fabricadigital/EzTemp-for-Raspberry-Pi/README.md

EzTempRH-for-Raspberry-Pi
=========================
