fabricadigital/EzTemp-for-Raspberry-Pi/board/EzTempRH-for-Raspberry-Pi Schematic.pdf

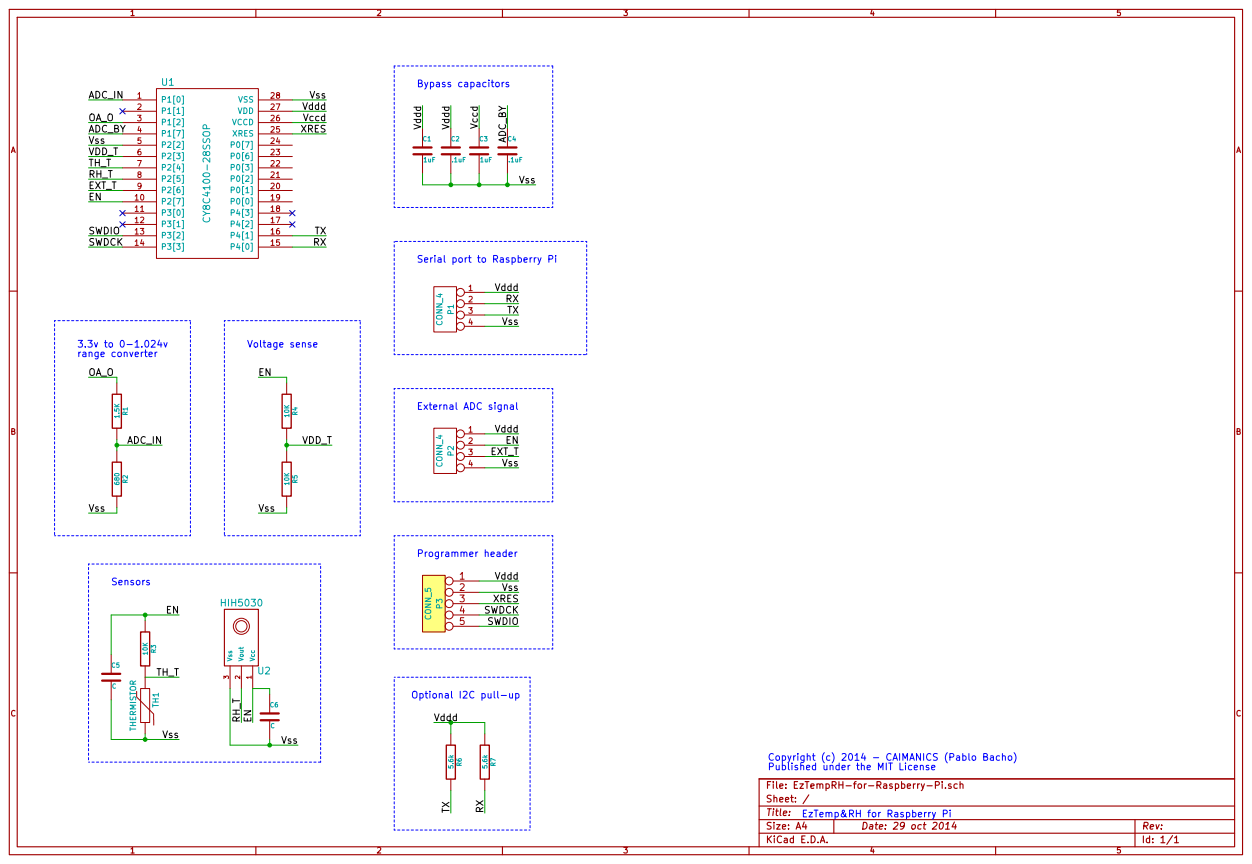
[picture p1: page 1]

Vss Vddd Vccd XRES

Serial port to Raspberry Pi

Copyright (c) 2014 - CAIMANICS (Pablo Bacho) Published under the MIT License

Id: 1/1 Title: File: EzTempRH-for-Raspberry-Pi.sch
Sheet: /

EzTemp&RH for Raspberry Pi
