fabricadigital/EzTemp-for-Raspberry-Pi/board/EzTempRH-for-Raspberry-Pi.kicad_pcb

## KiCad design board/EzTempRH-for-Raspberry-Pi.kicad_pcb (2015-06-03)

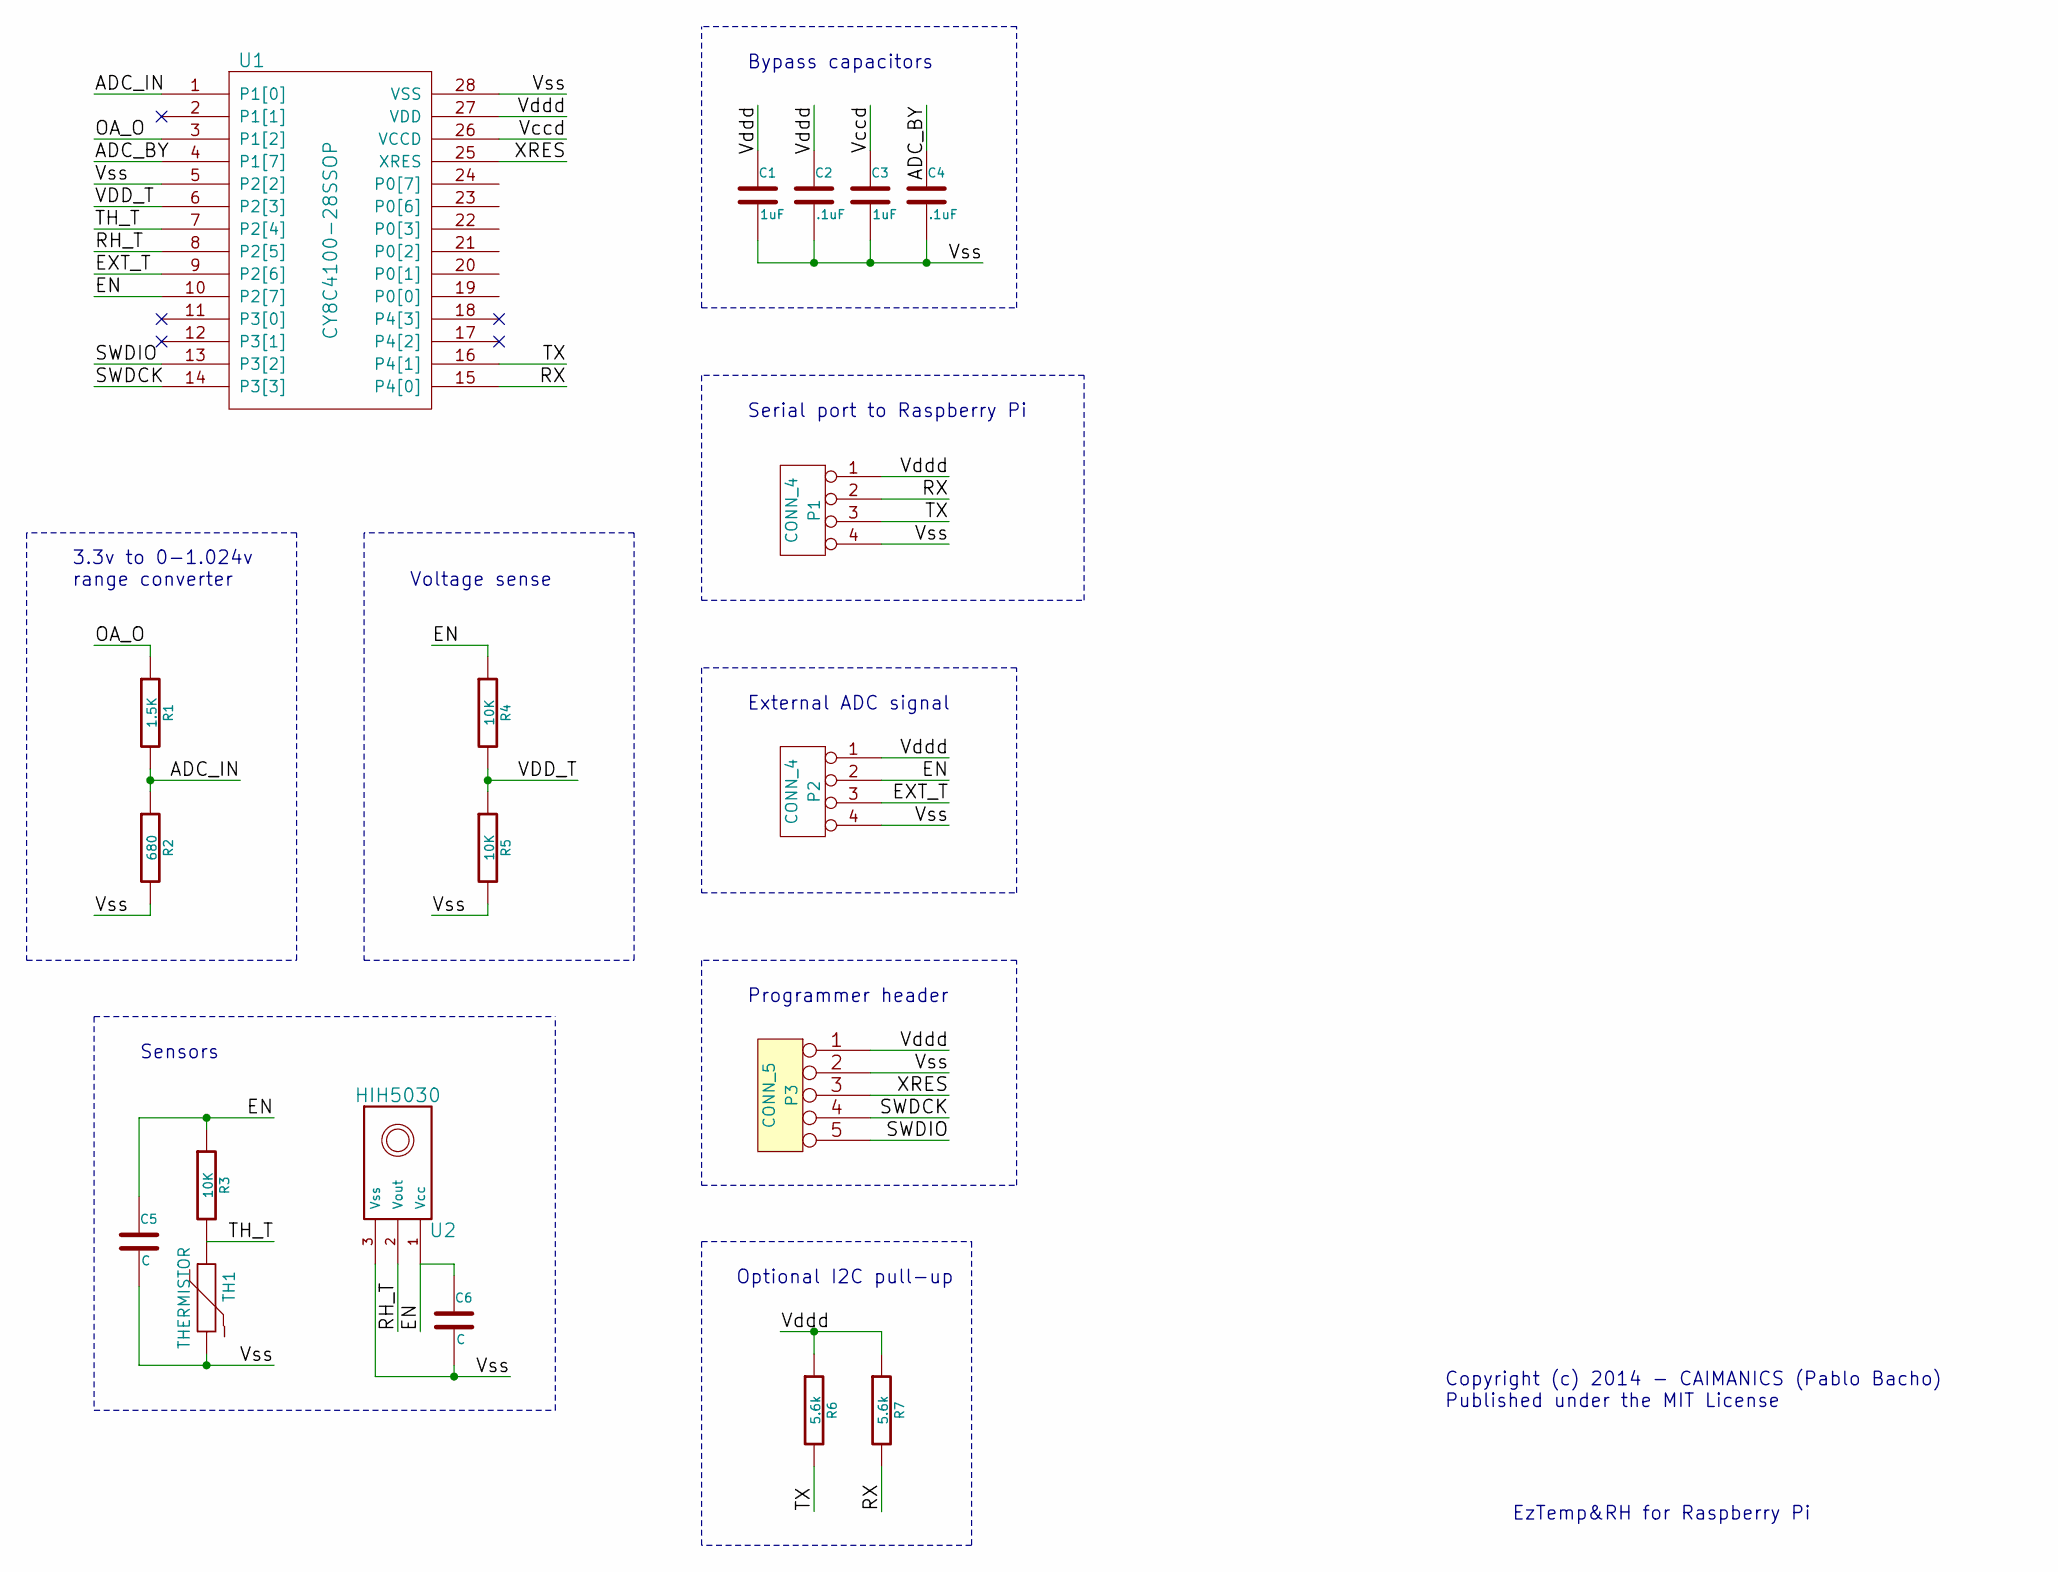
[picture p2: schematic EzTempRH-for-Raspberry-Pi.sch]

Parts:
C1, C3: 1uF
C2, C4: .1uF
C5, C6: C
P1, P2: CONN_4
P3: CONN_5
R1: 1.5K
R2: 680
R3, R4, R5: 10K
R6, R7: 5.6k
TH1: THERMISTOR
U1: CY8C4100-28SSOP
U2: HIH5030

Connections:
/ADC_BY: C4.1, U1.4 (P1[7])
/ADC_IN: R1.2, R2.1, U1.1 (P1[0])
/EN: C5.1, C6.1, P2.2, R3.1, R4.1, U1.10 (P2[7]), U2.1 (Vcc)
/EXT_T: P2.3, U1.9 (P2[6])
/OA_O: R1.1, U1.3 (P1[2])
/RH_T: U1.8 (P2[5]), U2.2 (Vout)
/RX: P1.2, R7.2, U1.15 (P4[0])
/SWDCK: P3.4, U1.14 (P3[3])
/SWDIO: P3.5, U1.13 (P3[2])
/TH_T: R3.2, TH1.1, U1.7 (P2[4])
/TX: P1.3, R6.2, U1.16 (P4[1])
/VDD_T: R4.2, R5.1, U1.6 (P2[3])
/Vccd: C3.1, U1.26 (VCCD)
/Vddd: C1.1, C2.1, P1.1, P2.1, P3.1, R6.1, R7.1, U1.27 (VDD)
/Vss: C1.2, C2.2, C3.2, C4.2, C5.2, C6.2, P1.4, P2.4, P3.2, R2.2, R5.2, TH1.2, U1.5 (P2[2]), U1.28 (VSS), U2.3 (Vss)
/XRES: P3.3, U1.25 (XRES)

Notes on the sheet:
Programmer header
Serial port to Raspberry Pi
External ADC signal
Bypass capacitors
Sensors
EzTemp&RH for Raspberry Pi
Copyright (c) 2014 - CAIMANICS (Pablo Bacho) Published under the MIT License
3.3v to 0-1.024v range converter
Voltage sense
Optional I2C pull-up

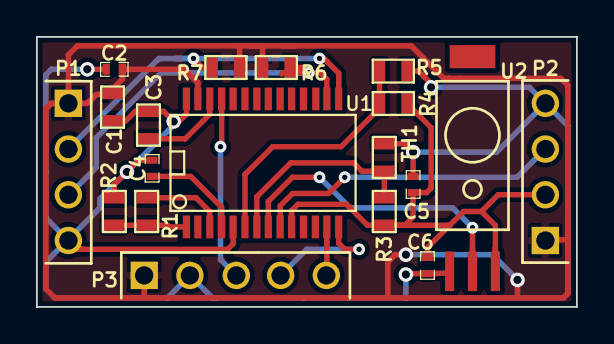
[picture p3: board EzTempRH-for-Raspberry-Pi.kicad_pcb from above]

Board: 2 copper layers, 30.0 x 15.0 mm, 19 parts (0 on the bottom side), 16 nets.
